mrhunsaker/Assistive_Switch_Interfaces/BLE_ADAPTIVE_SWITCH_EXPANDED_SCAFFOLD/BLE_Adaptive_Switch_District_Manual_Complete.docx

BLE ADAPTIVE SWITCH NODE

District Implementation Manual

Corrected & Expanded Edition

Written for teachers, paraeducators, AT specialists, and technology staff

Covers: device basics for the classroom · testing touch, proximity, and switch inputs

iPad/iPhone and Android pairing · firmware flashing · asset management · printable forms

Firmware: BLE_ADAPTIVE_SWITCH_EXPANDED_SCAFFOLD.ino + types_expanded.h

Device: ESP32-S3 SuperMini | BLE Profile: HID Keyboard (NimBLE stack)

Inputs: 6 capacitive touch · 1 proximity sensor · 4 mechanical switch jacks

Published by District Assistive Technology Department

# Table of Contents

# SECTION A — What This Device Does

The BLE Adaptive Switch Node is a small, wireless accessibility device built on the ESP32-S3 SuperMini microcontroller. It lets a student activate physical switches — things they touch, things they move near without touching, and things they press — and turns each activation into a standard Bluetooth keyboard keystroke.

Because it presents itself to the iPad, iPhone, or Android device as an ordinary Bluetooth keyboard, no app needs to be installed. iPadOS/iOS Switch Control and Android Switch Access both recognize it immediately and can map each input to scanning, selection, or navigation actions, exactly as they would for any commercial switch interface.

## A.1 The Three Kinds of Input

Input Type | How Many | How a Student Uses It | HID Keys Sent
Capacitive touch sensor | 6 | Lightly touch the sensor pad — no pressure needed | F1–F6
Proximity sensor | 1 | Move a hand or body part close to the sensor without touching it | F8
Mechanical switch (mono jack) | 4 | Press a standard adaptive switch plugged into a 3.5 mm jack | F9–F12

That is 11 independent inputs in total, and every single one sends a different key. This matters because Switch Control and Switch Access tell switches apart by which key arrives — if two inputs ever sent the same key, the software could not distinguish them.

## A.2 The LED — What Each Color Means

A single RGB indicator light (GPIO 48) gives instant feedback on every activation. The light tells you what TYPE of input just fired, not which specific sensor — this is a deliberate design choice that keeps the color code simple enough to memorize in a few seconds:

LED Color | Meaning
Green | A touch sensor was activated (F1–F6)
Red | The proximity sensor was activated (F8)
Blue | A switch / mono-jack input was activated (F9–F12)
Off / dark | Idle — no recent activation, or not yet connected

Remember it as: GREEN — you touched it. RED — it sensed you nearby. BLUE — you pressed it.

## A.3 What's Inside (Plain-Language Version)

- A small circuit board (ESP32-S3 SuperMini) that runs the program and talks over Bluetooth.
- Up to 6 small touch pads (TTP223 sensors) wired to the board.
- One proximity sensor that detects nearby motion without contact.
- Up to 4 standard 3.5 mm mono-jack sockets for plugging in adaptive switches.
- One small multicolor indicator light.
- A USB-C port for power and (for technology staff) for programming the device.
- An optional rechargeable battery for cable-free use during the school day.

No screen, no buttons to configure, and no companion app. Everything a teacher needs to do day-to-day is in Section B.

# SECTION B — For Teachers & Paraeducators: Daily Use and Testing

This section assumes no technical background. You will not need a computer, the Arduino IDE, or any programming knowledge to do anything described here. Everything in this section can be done with the device itself, the student's iPad/iPhone or Android device, and your own hands.

## B.1 Before You Start

Your technology department has already programmed (“flashed”) the device. You do not do that step — it is covered separately in Section D for IT staff. Your job is to power it on, pair it, test it, and use it.

## B.2 Powering the Device On

1. Plug in the USB-C cable, or switch on the battery if your unit has one.
2. Wait about 10 seconds. The indicator light may blink briefly during startup — this is normal.
3. Once startup finishes, the light goes dark and stays dark until an input is activated or it connects. A dark, idle light is the normal “ready and waiting” state, not a sign of failure.

## B.3 Pairing with an iPad or iPhone

1. On the iPad/iPhone, open Settings → Bluetooth.
2. Turn Bluetooth ON if it isn't already.
3. Under “Other Devices,” look for “BT Switch” (this is the device's default name; your district may have renamed it — see Section N).
4. Tap “BT Switch” to pair.
5. The device moves to “My Devices” and shows “Connected.”

After the first pairing, the iPad and the device reconnect automatically every time both are powered on — you should not need to repeat these steps daily.

## B.4 Pairing with an Android Tablet or Phone

1. On the Android device, open Settings → Connected devices (wording varies slightly by manufacturer/Android version) → Pair new device.
2. Look for “BT Switch” in the list of available devices.
3. Tap to pair. If a pairing code or confirmation prompt appears, accept it.
4. Confirm the device now shows as “Connected” under your paired/connected devices list.

This firmware has been verified on a Nokia G100 running Android 12 with Switch Access, and is expected to work the same way on other Android 9+ devices that support Bluetooth keyboards. If a specific Android device refuses to finish pairing, see Section G.3 — some Android devices need the battery status feature this device provides, and it is already built in.

## B.5 Turning On Switch Control (iPad / iPhone)

1. Open Settings → Accessibility → Switch Control.
2. Turn the Switch Control toggle ON. A scanning cursor will appear on screen.
3. Tap Switches → Add New Switch → External.
4. When prompted, activate the input you want to map (touch a pad, wave near the proximity sensor, or press a switch).
5. Give it a name you'll recognize (e.g., “Left Touch,” “Big Red Switch”) and choose the action it should perform.
6. Repeat for each input the student will use.

## B.6 Turning On Switch Access (Android)

1. If not already installed, install “Switch Access” from the Google Play Store.
2. Open Settings → Accessibility → Switch Access, and turn it ON.
3. Follow the in-app setup to add a switch: activate the desired input when prompted.
4. Assign the action you want that input to perform (e.g., move to next item, select).
5. Repeat for each input the student will use.

## B.7 Testing Each Kind of Input — The Most Important Section for Daily Use

Before any session with a student, and any time something seems “off,” test all three input types. You do not need any tools for this — just the device, and ideally a paired iPad or Android device so you can confirm the on-screen response as well as the LED.

### B.7.1 Testing a Touch Sensor

1. Lightly touch one of the touch pads (labeled Touch 1–6) with a fingertip or knuckle. No pressure is needed — these are capacitive sensors, like a phone screen.
2. Watch the indicator light: it should flash GREEN once.
3. If paired, watch the iPad/Android screen: the Switch Control or Switch Access cursor should respond exactly once per touch.
4. Lift off and touch again to confirm it fires once per touch, not continuously while held.

A touch sensor that never lights up green, or that fires repeatedly on its own without being touched, should be reported — see Section B.11.

### B.7.2 Testing the Proximity Sensor

1. Locate the proximity sensor — it is the small sensor window, separate from the touch pads and switch jacks.
2. Slowly bring a hand or other body part to within a few centimeters (roughly 1–4 inches) of the sensor window. Do not touch it — this sensor is designed to respond to nearness, not contact.
3. Watch the indicator light: it should flash RED once your hand is close enough.
4. Move your hand away. The sensor needs to see you move away before it will register the next activation — this is normal and prevents one long activation from repeating.

If the proximity sensor never lights up red no matter how close you get, it most likely needs technology staff to check its wiring or library configuration — see Section B.11 and Section G.

### B.7.3 Testing a Switch / Button Input

1. Plug a standard adaptive switch (3.5 mm mono plug) into one of the switch jacks (labeled Switch 1–4), if one is not already connected.
2. Press the switch.
3. Watch the indicator light: it should flash BLUE once per press.
4. Release and press again to confirm a single, clean activation each time.

### B.7.4 Quick Test Reference Card

Input Type | How to Test | LED Should Flash | On-Screen Result
Touch (Touch 1–6) | Lightly touch the pad | Green | Cursor moves / item selected, once per touch
Proximity | Hold hand ~1–4 in. away, then move it back | Red | Cursor moves / item selected, once per approach
Switch (Switch 1–4) | Press the connected switch | Blue | Cursor moves / item selected, once per press

## B.8 Daily Startup Checklist

☐ Power on the device and wait for startup to finish (light goes dark and idle).

☐ Confirm the iPad/Android device shows the device as “Connected.”

☐ Test at least one touch input — LED flashes green and the screen responds.

☐ Test the proximity sensor if the student uses it — LED flashes red and the screen responds.

☐ Test at least one switch input if the student uses it — LED flashes blue and the screen responds.

## B.9 Daily Shutdown Checklist

☐ Disconnect the device from the student's work area.

☐ Visually check all cables for damage, kinking, or fraying.

☐ Gently wiggle each connected adaptive switch cable to confirm it is seated firmly.

☐ Power off, or leave charging, per your building's protocol.

☐ Store the device in its designated location.

## B.10 Basic Troubleshooting (No Tech Required)

### A switch or sensor stopped responding mid-session

1. Check the Bluetooth/connection status on the iPad or Android device — it should show “Connected.”
2. If it shows disconnected, tap the device name to reconnect.
3. Check the physical cable between an adaptive switch and its jack — reseat it.
4. Try a different switch jack on the device, if available, to rule out a damaged jack.
5. If still unresponsive, contact your AT specialist or technology staff (Section B.11).

### The device disappeared from the Bluetooth/paired list

1. Power the device off completely, then back on. Wait about 15 seconds.
2. On the tablet, open Bluetooth/Connected devices settings — the device should reappear.
3. Tap to reconnect.
4. If it does not reappear within 30 seconds, try “forgetting” the device and re-pairing from scratch (Section B.3 / B.4).

### The LED never lights up at all, on any input

1. Confirm the device is actually powered — try a different USB-C cable, since many cables are charge-only.
2. If the device otherwise seems to work (it pairs, the screen responds) but the light itself never shows any color, this is most likely a hardware fault with the LED — report it (Section B.11). The device may still be safe to use for now since the LED is feedback only, not required for function.

## B.11 What to Report to Technology or AT Staff

Try the steps in B.10 first. Contact technology or AT staff if:

- The device will not power on after trying a different cable.
- Bluetooth will not reconnect after repeated restarts and re-pairing attempts.
- One or more inputs never register in any test, on any platform.
- There is visible physical damage to the enclosure, sensors, cables, or jacks.
- The proximity sensor never responds, even at very close range.
- The indicator light never illuminates at all, in any color.

# SECTION C — Hardware and GPIO Reference

This section is for AT specialists and technology staff who build, wire, or repair units. It reflects the actual firmware (BLE_ADAPTIVE_SWITCH_EXPANDED_SCAFFOLD.ino / types_expanded.h), not an earlier hardware revision.

## C.1 Hardware Components

Component | Purpose | Notes
ESP32-S3 SuperMini (ESP32S3FH4R2) | Main microcontroller | USB-C, BLE 5.0, in-package flash + PSRAM
TTP223 touch sensor modules (×6) | Capacitive touch input | 3.3V, digital output, active HIGH
I²C proximity sensor (×1) | Proximity input | APDS-9930, APDS-9960, VCNL4040, or VL53L0X — one per build
3.5 mm mono jack sockets (×4) | Adaptive switch input | Tip = signal, Sleeve = GND, INPUT_PULLUP
WS2812 NeoPixel LED | Visual feedback | GPIO 48, controlled by Adafruit NeoPixel
USB-C cable | Power and programming | Must be data-capable for flashing
3.7V 1100mAh LiPo battery (optional) | Cable-free power | Used with a TP4056 charge board

## C.2 GPIO Pin Reference

Signal | GPIO | Mode | HID Key | LED Color
Touch 1 | 1 | INPUT | F1 | Green
Touch 2 | 2 | INPUT | F2 | Green
Touch 3 | 4 | INPUT | F3 | Green
Touch 4 | 5 | INPUT | F4 | Green
Touch 5 | 6 | INPUT | F5 | Green
Touch 6 | 7 | INPUT | F6 | Green
Proximity (I²C) | SDA 8 / SCL 9 | I2C | F8 | Red
Switch 1 | 10 | INPUT_PULLUP | F9 | Blue
Switch 2 | 11 | INPUT_PULLUP | F10 | Blue
Switch 3 | 12 | INPUT_PULLUP | F11 | Blue
Switch 4 | 13 | INPUT_PULLUP | F12 | Blue
NeoPixel LED | 48 | OUTPUT | — | —

GPIO 3 is intentionally NOT used anywhere in this design, even though it would be electrically capable as a 7th touch input. It is a reset-time JTAG strapping pin, and this firmware avoids it entirely rather than relying on a sensor resting in the correct state at boot. As a direct result, F7 is permanently unused — this is by design, not an oversight.

## C.3 Reserved / Avoided Pins

GPIO | Reason
0 | BOOT button / boot-mode strapping
3 | JTAG-source strapping at reset (see callout above)
19 | USB D−
20 | USB D+
45 | VDD_SPI strapping (flash voltage)
46 | Boot-mode strapping (input-only)
48 | NeoPixel RGB LED (in use)

## C.4 Firmware Behavior Summary

- 35 ms software debounce on all 11 inputs, shared through one debounce routine.
- Edge-triggered: a keystroke fires once on activation, not repeatedly while held.
- Automatic BLE reconnection — the device re-advertises immediately if the host disconnects.
- LED fades smoothly toward its target color and fades back to off 250 ms after the last event, rather than snapping on/off.
- A standard Battery Service (UUID 0x180F, fixed at 100%) is included specifically because some Android hosts will not complete BLE HID pairing without one.

# SECTION D — Arduino IDE Setup and Firmware Flashing

This section is for technology staff only. Teachers and paraeducators do not need to perform any of these steps for normal classroom use.

## D.1 Prerequisites

Required hardware: ESP32-S3 SuperMini, a data-capable USB-C cable, a Windows/macOS/Linux computer.

Required files: BLE_ADAPTIVE_SWITCH_EXPANDED_SCAFFOLD.ino and types_expanded.h, in the same folder.

Internet connection: required for the initial board-support and library installation.

Estimated setup time: 30–60 minutes, mostly download/install waits.

## D.2 Install Arduino IDE

Download from https://www.arduino.cc/en/software for your operating system, run the installer with default options, and allow installation of USB/serial drivers when prompted.

## D.3 Install ESP32 Board Support

1. In Arduino IDE, open File → Preferences, and in “Additional Boards Manager URLs” paste: https://raw.githubusercontent.com/espressif/arduino-esp32/gh-pages/package_esp32_index.json
2. Open Tools → Board → Boards Manager, search “esp32,” and install “ESP32 by Espressif Systems.”

## D.4 Install Required Libraries

Open Sketch → Include Library → Manage Libraries and install each of the following:

Library | Required For | Notes
NimBLE-Arduino | BLE HID keyboard stack | by h2zero
Adafruit NeoPixel | Status LED | by Adafruit
SparkFun APDS9960 | Proximity sensor (default build) | Covers both APDS-9930 and APDS-9960
Adafruit VCNL4040 | Proximity sensor (alternate) | Only if using VCNL4040 instead
Adafruit VL53L0X | Proximity sensor (alternate) | Only if using VL53L0X instead

Wire is bundled with the ESP32 Arduino core and does not need separate installation.

## D.5 Choose the Proximity Sensor

Near the top of the .ino file, exactly one of the following four lines must be uncommented to match the physical sensor installed in the unit:

#define USE_APDS9930 (default) // #define USE_VCNL4040 // #define USE_VL53L0X // #define USE_APDS9960

If you change the sensor, also check PROX_I2C_ADDR and PROX_THRESHOLD a few lines below — each sensor family uses a different I²C address and a different practical threshold.

## D.6 Prepare and Open the Project

1. Place BLE_ADAPTIVE_SWITCH_EXPANDED_SCAFFOLD.ino and types_expanded.h together in one folder.
2. In Arduino IDE, choose File → Open and select the .ino file. types_expanded.h will open automatically in an adjacent tab — this is expected.

## D.7 Connect, Select Board and Port

1. Connect the board with a known data-capable USB-C cable.
2. Tools → Board → ESP32 Arduino → ESP32S3 Dev Module.
3. Tools → Port → select the port that appeared when the board was connected.

Selecting any board type other than ESP32S3 Dev Module is the most common cause of first-time compile or upload failure.

## D.8 Compile and Upload

1. Click Verify (✓) first. Expected result: “Done compiling.”
2. Click Upload (→). Expected final message: “Hard resetting via RTS pin…”
3. If upload fails on a fresh board, hold BOOT, briefly press and release RESET, release BOOT, then retry Upload within about 3 seconds.

### D.8.1 Common Compilation Errors

Error Message | Cause | Resolution
NimBLEDevice.h: No such file or directory | NimBLE-Arduino not installed | Install NimBLE-Arduino via Library Manager
Adafruit_NeoPixel.h: No such file or directory | NeoPixel library not installed | Install Adafruit NeoPixel via Library Manager
types_expanded.h: No such file or directory | Header not in the same folder | Move both files into one folder together
HIDKeyboardTypes.h: No such file or directory | Header is included but unused | Delete that #include line; no named constants from it are used
SparkFun_APDS9960.h: No such file or directory | Proximity library not installed, or wrong #define selected | Install the library matching the #define in Section D.5

## D.9 Serial Monitor Verification

Open Tools → Serial Monitor, set the baud rate to 115200, and reset the board. You should see setup logging end with “=== SETUP COMPLETE ===” and “=== BLE READY, ADVERTISING ===.” Every touch, proximity, and switch activation also logs its GPIO and assigned key here — this is the most reliable way to confirm a specific sensor by number, since the LED only reports input type.

# SECTION E — iPad / iOS Pairing and Switch Control Configuration (Detailed)

This is the detailed reference version of Section B.3/B.5, intended for AT specialists configuring a unit for a specific student for the first time.

## E.1 Pair the Device

1. Power on the BLE Switch Node.
2. On the iPad, open Settings → Bluetooth and ensure Bluetooth is ON.
3. Under Other Devices, locate “BT Switch” and tap to pair.
4. Accept any pairing confirmation prompts.
5. Confirm the device appears under My Devices showing Connected.

After first pairing, the iPad and switch node reconnect automatically on future power-ups, as long as the iPad has not “forgotten” the device.

## E.2 Configure Switch Control

### E.2.1 Enable Switch Control

1. Open Settings → Accessibility → Switch Control.
2. Tap the Switch Control toggle to turn it ON. The scanning cursor appears on screen.

### E.2.2 Add Each Switch

1. Within Switch Control settings, tap Switches → Add New Switch → External.
2. When prompted “Activate the switch,” touch the desired sensor or press the connected adaptive switch.
3. Enter a descriptive name (e.g., “Left Touch,” “Proximity – Head Approach,” “Right Switch”).
4. Select the Switch Control action to assign (e.g., Select Item, Move to Next Item).
5. Tap Save, and repeat for each input you want configured.

## E.3 Verify Input Operation

With Bluetooth connected, Switch Control enabled, and the Serial Monitor open (if a computer is available), activate each input and confirm:

Input Activated | Expected Serial Output | LED Color | Expected iPad Action
Touch 1–6 (any) | TOUCH n GPIO## -> F# (0x3A–0x3F) | Green | Configured Switch Control action fires once
Proximity | PROX near -> F8 (0x41) | Red | Configured Switch Control action fires once
Switch 1–4 (any) | SWITCH n GPIO## -> F# (0x42–0x45) | Blue | Configured Switch Control action fires once

# SECTION F — Android Pairing and Switch Access Configuration (Detailed)

This is the detailed reference version of Section B.4/B.6.

## F.1 Pair the Device

1. Power on the BLE Switch Node.
2. On the Android device, open Settings → Connected devices → Pair new device (menu names vary by manufacturer and Android version).
3. Locate “BT Switch” in the list of nearby devices and tap to pair.
4. Accept any confirmation/pairing-code prompts.
5. Confirm the device shows as Connected in the Connected devices list.

If pairing stalls or silently fails on a specific Android device, confirm the firmware build includes the Battery Service (UUID 0x180F) described in Section C.4 — this was required to complete pairing on the Nokia G100 / Android 12 reference device used to verify this firmware.

## F.2 Install and Enable Switch Access

1. Install “Switch Access” from the Google Play Store if not already present.
2. Open Settings → Accessibility → Switch Access and turn it ON.
3. Follow the in-app prompts to add a new switch: activate the desired physical input when asked.
4. Assign the action (e.g., Move to next item, Select) for that input.
5. Repeat for each input the student will use.

## F.3 Verify Input Operation

Input Activated | LED Color | Expected Android Action
Touch 1–6 (any) | Green | Configured Switch Access action fires once
Proximity | Red | Configured Switch Access action fires once
Switch 1–4 (any) | Blue | Configured Switch Access action fires once

# SECTION G — Troubleshooting Flowcharts and Escalation

## G.1 Device Will Not Power On

Step | Check | If NO — Action | If YES — Action
1 | USB-C cable connects device to computer/charger | Use a known data-capable cable | Proceed to step 2
2 | Does any LED appear during startup? | Try a different USB port/charger | Proceed to step 3
3 | Still dark after two cables, two sources? | Replace ESP32-S3 SuperMini board | Proceed to step 4
4 | Serial Monitor shows startup messages? | Reflash firmware per Section D | Device is functional — check BLE

## G.2 Device Will Not Upload (Flashing Failure)

Step | Check | If FAIL — Action | If PASS — Action
1 | Board set to ESP32S3 Dev Module? | Change board selection | Proceed to step 2
2 | Correct serial port selected? | Replug USB, refresh port list | Proceed to step 3
3 | Upload attempt — any error? | Try manual BOOT + RESET entry (Section D.8) | Proceed to step 4
4 | Still failing after BOOT entry? | Reinstall the ESP32 board package | Upload complete

## G.3 Bluetooth Will Not Connect

Step | Check | Negative — Action | Positive — Action
1 | Serial Monitor shows ADVERTISING STARTED? | Reflash firmware | Proceed to step 2
2 | “BT Switch” visible in the host's Bluetooth scan? | Reboot device, rescan on host | Proceed to step 3
3 | Pairing attempt succeeds? | Forget device on host, reboot device, retry | Proceed to step 4
4 | Host shows Connected? | Enable Switch Control / Switch Access | Configure switches

Android-specific: if pairing repeatedly fails at the “connecting…” stage specifically on Android (but works fine on iPad), confirm the firmware build includes the Battery Service — some Android BLE HID stacks require it to finalize the connection.

## G.4 Inputs Not Registering

Symptom | First Check | Second Check | Escalate If
Touch sensor unresponsive | Serial Monitor for TOUCH messages | Re-seat TTP223 wiring | No Serial output — replace TTP223
Proximity sensor unresponsive | Serial Monitor for an I²C error code at startup | Verify SDA=8/SCL=9 wiring and correct #define (Section D.5) | Sensor still silent — replace sensor or check address
Switch unresponsive | Test switch continuity with a multimeter | Check 3.5 mm jack seating | No continuity — replace switch or cable
Input fires repeatedly on its own | Check for debris/moisture on a touch pad | Confirm 35 ms debounce is intact in firmware | Replace sensor if still erratic
Wrong on-screen action triggered | Verify Switch Control / Switch Access assignment | Re-assign the action in settings | Contact AT specialist

## G.5 Escalation Matrix

Issue Level | Who Handles | Response Time | Escalate To
Bluetooth reconnect failure | Teacher or paraeducator | Immediate — reboot device | Tech staff if unresolved in 5 min
A switch/sensor not registering | Teacher or paraeducator | Immediate — check cable/test | AT specialist if hardware suspected
Firmware reflash required | Technology staff | Same school day | District AT coordinator
Hardware damage / board failure | Technology staff | Same school day | Replacement unit dispatch
New device deployment | Technology staff | Per deployment schedule | District IT for inventory entry
Student evaluation / configuration change | AT specialist | Per IEP timeline | Special education director

# SECTION H — Formal Acceptance Testing Procedure

Every unit must pass acceptance testing before assignment to a student. This procedure verifies firmware correctness, all 11 inputs, and connectivity on whichever platform(s) the unit will be used with.

## H.1 Pre-Deployment Acceptance Form

Field | Entry
Device ID / Asset Number
Bluetooth Advertised Name
Firmware Source File | BLE_ADAPTIVE_SWITCH_EXPANDED_SCAFFOLD.ino
ESP32 Chip ID (from Serial Monitor)
Proximity Sensor Type Installed
Target Platform(s) | ☐ iPad/iOS ☐ Android
Date of Testing
Technician Name
Assigned Student / Room (if known)

## H.2 Hardware Checks

☐ Visual inspection — no physical damage, loose wiring, or cracked enclosure

☐ USB-C connector seated and functional

☐ All 6 TTP223 touch sensors present and attached

☐ Proximity sensor present, attached, and wired to SDA=8 / SCL=9

☐ All 4 mono switch jacks present and undamaged

☐ NeoPixel LED present and not physically damaged

## H.3 Firmware and Startup Checks

☐ Device powers on — startup sequence visible

☐ Serial Monitor at 115200 baud shows the full setup sequence ending in “=== SETUP COMPLETE ===”

☐ “=== BLE READY, ADVERTISING ===” message confirmed

☐ Proximity sensor initializes without an I²C error in Serial Monitor

## H.4 Bluetooth Checks

☐ “BT Switch” (or custom name) visible in target device's Bluetooth scan

☐ Pairing completes without errors

☐ Target device shows Connected status

☐ Power-cycle reconnection test: power off, power back on, host reconnects automatically within ~10 seconds

## H.5 Input Verification — All 11 Inputs

☐ Touch 1 (GPIO 1) → F1, Serial shows TOUCH 0, LED flashes Green

☐ Touch 2 (GPIO 2) → F2, Serial shows TOUCH 1, LED flashes Green

☐ Touch 3 (GPIO 4) → F3, Serial shows TOUCH 2, LED flashes Green

☐ Touch 4 (GPIO 5) → F4, Serial shows TOUCH 3, LED flashes Green

☐ Touch 5 (GPIO 6) → F5, Serial shows TOUCH 4, LED flashes Green

☐ Touch 6 (GPIO 7) → F6, Serial shows TOUCH 5, LED flashes Green

☐ Proximity → F8, Serial shows PROX near, LED flashes Red

☐ Switch 1 (GPIO 10) → F9, Serial shows SWITCH 0, LED flashes Blue

☐ Switch 2 (GPIO 11) → F10, Serial shows SWITCH 1, LED flashes Blue

☐ Switch 3 (GPIO 12) → F11, Serial shows SWITCH 2, LED flashes Blue

☐ Switch 4 (GPIO 13) → F12, Serial shows SWITCH 3, LED flashes Blue

## H.6 Switch Control / Switch Access Integration Test

☐ Switch Control (iPad) or Switch Access (Android) enabled on the target device

☐ All intended inputs assigned in the accessibility settings

☐ Scanning/selection responds correctly to touch inputs

☐ Scanning/selection responds correctly to the proximity sensor

☐ Scanning/selection responds correctly to switch inputs

## H.7 Final Result

Result | Technician Signature | Date
PASS / FAIL (circle one)

If FAIL: document the failure mode below and do not deploy the unit until resolved.

Failure notes (continue on back if needed) | Date reviewed

# SECTION I — Asset Management

## I.1 Inventory Record Template

Maintain one row per physical device in the district inventory system (spreadsheet, database, or asset management platform).

Field | Description / Format
Asset Number | District-assigned unique identifier (e.g., AT-2026-001)
Bluetooth Name | Advertised BLE name programmed in firmware (default: BT Switch)
Proximity Sensor Type | APDS-9930 / APDS-9960 / VCNL4040 / VL53L0X
Build Date | Date unit was assembled and flashed
Acceptance Test Date | Date of most recent acceptance test (Section H)
Acceptance Test Result | PASS or FAIL
Current Building / Room | Building name or code and room number
Assigned Staff | Teacher or AT specialist name
Assigned Student | Student ID only — never the student's name
Last Inspection Date | Date of most recent monthly inspection
Next Inspection Due | Calculated 30 days from last inspection
Decommission Date | Date unit was retired from service

## I.2 Device Checkout Form

Complete when any unit leaves the technology department or changes assignment.

Field | Entry
Asset Number
Bluetooth Name
Checked Out To (Staff Name)
Building / Room
Student ID (if assigned)
Date Checked Out
Expected Return Date (if temporary)
Condition at Checkout | Good / Minor wear / Needs repair

Technology Staff Signature / Date | Receiving Staff Signature / Date

# SECTION J — Paraeducator Quick Reference Card

PRINT THIS PAGE AND KEEP IT WITH THE DEVICE. Laminate for durability.

## Every Morning

☐ Power on the switch node

☐ Host device (iPad or Android) shows Connected

☐ Activate one touch input — LED flashes Green, screen responds

☐ Activate the proximity sensor (if used) — LED flashes Red, screen responds

☐ Activate one switch input (if used) — LED flashes Blue, screen responds

## LED Color Guide

LED Color | What It Means
Green | A touch sensor (Touch 1–6) was activated
Red | The proximity sensor was activated
Blue | A switch (Switch 1–4) was activated
Dark / Off | No input, or no connection yet

## If a Switch Stops Working

Try This First | Then Try | Then Call
Check Bluetooth — shows Connected? | Reboot device: power off, wait 10 sec, power on | AT specialist or technology staff
Wiggle the cable at the jack | Try a different jack on the device | Technology staff if hardware issue
Restart Switch Control/Access: OFF, wait 5 sec, ON | Forget and re-pair the device | AT specialist if software/config issue

## If the Device Disappears from the Paired List

1. Power off the switch node.
2. Wait 10 seconds.
3. Power it back on.
4. Open Bluetooth/Connected devices settings on the host.
5. The device name should reappear — tap to reconnect.

## Who to Call

Situation | Contact
Bluetooth will not reconnect after restart | Technology Department
A switch is not working — hardware suspected | Technology Department
Student's scanning pattern needs adjustment | AT Specialist
Switch Control / Switch Access actions need reconfiguring | AT Specialist or Teacher
Physical damage to the device | Technology Department

# SECTION K — Technology Department Maintenance Procedures

## K.1 Monthly Maintenance Checklist

Complete for every active unit each calendar month. File completed checklists in the device folder.

☐ Confirm firmware matches the district-approved version

☐ Power on — complete startup sequence visible in Serial Monitor

☐ Bluetooth advertisement visible from a host scan

☐ Pair or reconnect — host shows Connected

☐ Touch 1–6 each activate — correct Serial output and Green LED

☐ Proximity sensor activates — correct Serial output and Red LED

☐ Switch 1–4 each activate — correct Serial output and Blue LED

☐ Power-cycle reconnection test passes

☐ Physical inspection — no damage

Technician Signature | Date

## K.2 Quarterly Maintenance

- Physical inspection of all units: enclosure, connectors, cables.
- Full inventory audit: confirm physical count matches database records.
- Confirm all units run the current district-approved firmware version.
- Review incident reports filed since the last quarterly review.
- Update inventory records with current building/room/staff assignments.

## K.3 Annual Maintenance

- Reflash all units with the then-current district-approved firmware.
- Complete a full acceptance test (Section H) on every unit after reflashing.
- Update the firmware version log (Section O) with the annual version.
- Review and update training materials if firmware behavior changed.
- Conduct a full inventory audit and decommission damaged/obsolete units.

## K.4 Firmware Update Approval Form

Field | Entry
New Firmware Version / Filename
Previous Firmware Version / Filename
Date of Change
Summary of Changes
Testing Completed By
Number of Units Tested
Pass Rate
Approved By (Technology Director)
Approved By (AT Coordinator)
Deployment Date

Technology Director Signature / Date | AT Coordinator Signature / Date

# SECTION L — AT Specialist Evaluation Form

Completed by the Assistive Technology Specialist when evaluating a student's use of the BLE Adaptive Switch Node.

FERPA NOTICE: This form contains student-specific information. Store per district FERPA policies. Do not attach to or store with the device hardware.

## L.1 Student and Device Information

Field | Entry
Student ID (do not write name on device forms)
Evaluation Date
AT Specialist Name
IEP Meeting Date (if applicable)
Device Asset Number Used During Evaluation
Target Platform | ☐ iPad/iOS ☐ Android

## L.2 Access Method Evaluated

☐ Capacitive touch sensors (one or more of Touch 1–6)

☐ Proximity sensor

☐ Mechanical switches via mono jack (one or more of Switch 1–4)

☐ Combination of touch, proximity, and/or switch

☐ Access method currently under evaluation — not yet determined

### L.2.1 Physical Positioning

Describe switch or sensor placement observed during evaluation:

### L.2.2 Accuracy

Metric | Observation
Correct activations per 10 attempts
Unintended activations per 10 attempts
Average time from intent to activation
Consistent activation force / approach distance? | Yes / No / Variable

### L.2.3 Fatigue

Metric | Observation
Duration of sustained use before fatigue signs
Observed fatigue indicators
Recommended maximum session length

### L.2.4 Student Response to LED Feedback

☐ Student notices and responds to LED color changes

☐ LED feedback does not appear to influence student behavior

☐ LED feedback is distracting — consider covering or disabling

## L.3 Recommendations

Switch configuration recommendation for IEP:

Positioning recommendation:

Training recommendation for staff:

Follow-up evaluation recommended: Yes / No If yes, within: ________ weeks

AT Specialist Signature | Date

# SECTION M — FERPA and Student Privacy Guidance

## M.1 What FERPA Requires

The Family Educational Rights and Privacy Act (FERPA) prohibits unauthorized disclosure of personally identifiable information from student education records. Technology staff and educators must follow this section when deploying the BLE Adaptive Switch Node.

## M.2 What Must Not Be Stored on the Device

The ESP32-S3 SuperMini has no non-volatile storage accessible to the firmware beyond the program flash itself. No student information of any kind is stored on or transmitted by the firmware. District staff must still follow the naming restrictions below.

### M.2.1 Bluetooth Device Names Must Not Contain:

- Student full names or partial names
- Student ID numbers
- Any medical diagnosis or disability category
- Classroom identifiers that would allow identification of a specific student

Compliant Naming Examples | Non-Compliant Naming Examples
BT Switch B1-001 | BT Switch John Smith (contains a student name)
BT Switch Room 14A | Switch 042839 (contains a student ID)
BT Switch 07 | CP Switch Room 14 (contains a disability category)

## M.3 Inventory Systems

- Inventory databases linking Asset Numbers to student identifiers must comply with district FERPA data governance policies.
- Printed inventory sheets with student ID assignments must be stored securely, never left in classrooms.
- Device labels must use asset numbers only, never student names.

## M.4 Evaluation Records

- AT specialist evaluation forms (Section L) contain student-identifiable information and must be stored in the student's file per FERPA requirements.
- Do not photograph, scan, or transmit these forms through non-secure channels.
- Completed evaluation forms must not be left with the physical device or in unsecured classrooms.

## M.5 Questions

Contact your district FERPA compliance officer or special education director with any questions about whether a specific practice complies with FERPA.

# SECTION N — Multi-Building Deployment Standards

## N.1 Device Naming Convention

When deploying multiple units across buildings, program a unique Bluetooth name into each unit before flashing to prevent confusion when several devices are powered on in the same space.

Format: BT Switch [Building Code]-[Unit Number] — Examples: BT Switch B1-001, BT Switch B1-002, BT Switch ES-014, BT Switch MS-003

## N.2 How to Change the Bluetooth Name

Before compiling firmware for a specific unit, locate this line near the top of setupBLE() in the .ino file:

NimBLEDevice::init("BT Switch");

Change the string to the unit's assigned name, for example:

NimBLEDevice::init("BT Switch B1-001");

Compile and flash. The advertised name (set elsewhere via advData.setName(...) in the same function) should be updated to match. Each unit then advertises its unique name.

## N.3 Central Inventory Database

Maintain a single district-level inventory tracking all units regardless of building, including at minimum: asset number, Bluetooth name, current building/room/staff, student ID assignment (secured per FERPA), proximity sensor type, and last acceptance test date.

## N.4 Cross-Building Transfer Procedure

1. Update the inventory record with the new building, room, and staff assignment.
2. Confirm the Bluetooth name is appropriate for the new location (rename in firmware if needed).
3. Complete a transfer inspection using the monthly checklist (Section K.1).
4. Notify the receiving building's AT specialist of the transfer.
5. Confirm the receiving host device can successfully pair or reconnect.

# SECTION O — Change Management and Firmware Version Control

## O.1 Firmware Version Log

Record every firmware version ever deployed district-wide. Never delete previous entries.

Version | Release Date | Approved By | Change Summary | Rollback Procedure
2.0.0 (Expanded Scaffold, board-verified) | | | 11-input redesign: 6 touch + 1 proximity + 4 switch; 3-color LED scheme; Battery Service added for Android | Section O.3

## O.2 Change Approval Process

- Technology staff or AT coordinator identifies the need for a firmware change.
- The change is documented and tested on at least 2 units before broad deployment.
- Technology Director and AT Coordinator review and sign the Firmware Update Approval Form (Section K.4).
- Approved firmware is deployed to all units within the designated maintenance window.
- All units are acceptance tested post-flash (full or abbreviated, per supervisor direction).
- The version log (O.1) is updated.

## O.3 Rollback Procedure

1. Locate the previous approved firmware source files in district technology archive storage.
2. Flash all affected units with the previous version using the standard procedure (Section D).
3. Document the rollback in the firmware version log with date and reason.
4. Do not deploy the problem version to additional units until the issue is resolved.

Retain the full source for every version ever deployed (both the .ino and the matching types_expanded.h) in district network storage, not only on individual technicians' computers. Losing a previous version removes the ability to roll back.

# SECTION P — Printable Appendices

## Appendix A — Device Checkout Form

(See Section I.2 for the full form. Reproduce this page for daily use.)

Field | Entry
Asset Number
Bluetooth Name
Date Checked Out
Checked Out To
Building / Room
Student ID
Condition at Checkout | Good / Minor wear / Needs repair
Expected Return Date

Borrowing Staff Signature / Date | Technology Staff Signature / Date

## Appendix B — Classroom Daily Verification Form

Teacher or paraeducator completes daily. Keep with the device or in the classroom binder.

Date | Powered On | Connected | Platform | Inputs Tested | Issue Noted | Initials
| ☐ | ☐ | iPad / Android | ☐ Touch ☐ Prox ☐ Switch
| ☐ | ☐ | iPad / Android | ☐ Touch ☐ Prox ☐ Switch
| ☐ | ☐ | iPad / Android | ☐ Touch ☐ Prox ☐ Switch
| ☐ | ☐ | iPad / Android | ☐ Touch ☐ Prox ☐ Switch
| ☐ | ☐ | iPad / Android | ☐ Touch ☐ Prox ☐ Switch
| ☐ | ☐ | iPad / Android | ☐ Touch ☐ Prox ☐ Switch
| ☐ | ☐ | iPad / Android | ☐ Touch ☐ Prox ☐ Switch
| ☐ | ☐ | iPad / Android | ☐ Touch ☐ Prox ☐ Switch

## Appendix C — Incident Report Form

Field | Entry
Asset Number
Date of Incident
Reported By (name and role)
Building / Room
Student ID (if involved)
Description of Incident
Immediate Action Taken
Follow-up Required? | Yes / No
Assigned To
Resolution Date
Resolution Summary

Reporting Staff Signature / Date | Technology Staff Signature / Date

## Appendix D — Annual Inspection Form

☐ Enclosure — no cracks, loose parts, or sharp edges

☐ USB-C connector functional for charging and data

☐ All 6 TTP223 touch sensors present and responsive

☐ Proximity sensor present, wired, and responsive

☐ All 4 mono switch jacks present and functional

☐ NeoPixel LED illuminates Green / Red / Blue correctly

☐ Full startup sequence confirmed in Serial Monitor

☐ Bluetooth advertising and pairing functional on intended platform(s)

☐ All 11 inputs verified per the Acceptance Test (Section H)

☐ Firmware version matches the current district-approved version

☐ Inventory record updated

Annual Inspection Technician / Date | Technology Director Approval / Date

## Appendix E — Firmware Update Approval Form

(See Section K.4 for the full form. Reproduce this page as needed.)

Field | Entry
New Firmware Version / Filename
Previous Firmware Version / Filename
Summary of Changes
Test Units Count
Test Pass Rate
Approved By — Technology Director
Approved By — AT Coordinator
Deployment Date
Rollback Instructions (attach or reference)

Technology Director Signature / Date | AT Coordinator Signature / Date

## Appendix F — AT Evaluation Worksheet (Abbreviated Field Copy)

(Full form in Section L. This is a condensed field copy for use during evaluation sessions.)

Field | Entry
Student ID
Evaluation Date
AT Specialist
Device Asset Number
Platform | iPad / Android
Access Method Evaluated | Touch / Proximity / Switch / Combination
Correct activations / 10 trials
Unintended activations / 10 trials
Fatigue threshold observed
Recommended switch configuration
Follow-up needed? | Yes / No — Within: ___ weeks

AT Specialist Signature | Date

BLE Adaptive Switch Node — District Implementation Manual Corrected & Expanded Edition
