mrhunsaker/Assistive_Switch_Interfaces/BLE_ADAPTIVE_SWITCH_EXPANDED_SCAFFOLD/old/BLE_Adaptive_Switch_District_Manual_Complete.docx

BLE ADAPTIVE SWITCH NODE

District Deployment Manual

Expanded Edition

Comprehensive guide for teachers, paraeducators, AT specialists,

technology staff, and district administrators.

Covers: Arduino IDE setup · Firmware flashing · iPad pairing · District deployment

Asset management · Staff training · Compliance · Printable forms

Firmware: BLE_TTP223_SWITCH_FUNCTION_STATE_MODEL

Device: ESP32-S3 Supermini | BLE Profile: HID Keyboard

Published by District Assistive Technology Department

# Table of Contents

# SECTION A — SYSTEM DOCUMENTATION

## A.1 What This Device Does

The BLE Adaptive Switch Node is a small, wireless accessibility device built on the ESP32-S3 Supermini microcontroller. It bridges physical switch inputs — capacitive touch sensors and adaptive switches — to Apple iPads and iPhones through Bluetooth Low Energy (BLE) using the standard HID Keyboard profile.

Students who cannot use a standard touchscreen can activate physical switches to drive all of iPadOS Switch Control, including scanning, selection, and full app navigation.

### A.1.1 HID Keyboard Mapping

Input | Bluetooth Action Sent | Default Switch Control Function
Touch Sensor 1 / Switch Jack 1 | Shift + Tab | Move to previous item
Touch Sensor 2 / Switch Jack 2 | Tab | Move to next item / Scan
Touch Sensor 3 / Switch Jack 3 | Enter | Select highlighted item

### A.1.2 Bluetooth Identity

Default Bluetooth advertisement name: BT Switch Node

Profiles supported: BLE HID Keyboard

Bonding: Enabled (reconnects automatically on power-up)

Range: Approximately 10 meters line-of-sight

## A.2 Hardware Components

Component | Purpose | Notes
ESP32-S3 Supermini | Main microcontroller | USB-C, BLE 5.0
TTP223 touch sensor modules (x3) | Capacitive touch input | 3.3V, digital output
3.5 mm mono jack sockets (x3) | Adaptive switch input | Tip = signal, Sleeve = GND
WS2812B NeoPixel LED | Visual feedback | GPIO 48, controlled by Adafruit NeoPixel
USB-C cable | Power and programming | Data-capable cable required for flashing

### A.2.1 GPIO Pin Reference

Signal | GPIO | Mode | Connected To
Touch 1 | GPIO 4 | INPUT | TTP223 OUT pin
Touch 2 | GPIO 5 | INPUT | TTP223 OUT pin
Touch 3 | GPIO 6 | INPUT | TTP223 OUT pin
Switch Jack 1 | GPIO 10 | INPUT_PULLUP | 3.5 mm jack tip
Switch Jack 2 | GPIO 11 | INPUT_PULLUP | 3.5 mm jack tip
Switch Jack 3 | GPIO 12 | INPUT_PULLUP | 3.5 mm jack tip
NeoPixel LED | GPIO 48 | OUTPUT | WS2812B DIN

### A.2.2 LED Status Colors

Activation | LED Color | Meaning
Touch Sensor 1 | Purple | Shift+Tab sent
Touch Sensor 2 | Red | Tab sent
Touch Sensor 3 | Green | Enter sent
Switch Jack 1 | Blue | Shift+Tab sent
Switch Jack 2 | Cyan | Tab sent
Switch Jack 3 | Yellow | Enter sent
No connection | Off / slow pulse | Advertising, no host paired

## A.3 Firmware Behavior

- 35 ms software debounce on all inputs prevents false triggers
- Automatic BLE reconnection — device re-advertises if host disconnects
- Bluetooth bonding — iPad remembers the device after first pairing
- Non-blocking LED fades — switch inputs remain responsive during LED animation
- Touch sensors: active HIGH (TTP223 output goes HIGH on touch)
- Switch jacks: active LOW (INPUT_PULLUP; switch closure pulls GPIO to ground)
- Firmware converts both input types to a consistent Pressed = TRUE model internally

# SECTION B — ARDUINO IDE SETUP AND FIRMWARE FLASHING

## B.1 Prerequisites

Required hardware: ESP32-S3 Supermini, USB-C data cable, Windows/macOS/Linux computer

Required files: BLE_TTP223_SWITCH_FUNCTION_STATE_MODEL.ino and types.h

Internet connection required for initial installation of board support and libraries.

Estimated total setup time: 30–60 minutes (most time is download/install waits).

## B.2 Install Arduino IDE

### B.2.1 Download

Navigate to: https://www.arduino.cc/en/software

Operating System | Download Target
Windows 10/11 (64-bit) | Windows Win 10 and newer, 64-bit
macOS Intel | macOS Intel
macOS Apple Silicon (M1/M2/M3) | macOS Apple Silicon
Linux | Appropriate Linux AppImage or package

### B.2.2 Install

1. Run the downloaded installer.
2. Accept all default options.
3. When prompted, allow installation of USB drivers, serial drivers, and device drivers.
4. Launch Arduino IDE when installation completes.

SCREENSHOT AI-01: Arduino IDE first launch. Capture the full IDE window showing the default empty sketch.

F2F2F2

## B.3 Install ESP32 Board Support

### B.3.1 Add Board Manager URL

5. In Arduino IDE, open: File → Preferences
6. Locate the field labeled: Additional Boards Manager URLs
7. Paste the following URL exactly:

https://raw.githubusercontent.com/espressif/arduino-esp32/gh-pages/package_esp32_index.json

8. Click OK.

### B.3.2 Install ESP32 Package

9. Open: Tools → Board → Boards Manager
10. In the search box, type: esp32
11. Locate: ESP32 by Espressif Systems
12. From the version dropdown, select: 2.0.17 (this is the version validated with this firmware)
13. Click Install.
14. Wait for installation to complete. This may take 5–15 minutes on a slower connection.

SCREENSHOT AI-02: File → Open menu sequence.

F2F2F2

SCREENSHOT AI-03: Boards Manager with 'esp32' in the search field.

F2F2F2

SCREENSHOT AI-04: ESP32 package installation page with version 2.0.17 selected and Install button.

F2F2F2

## B.4 Install Required Libraries

### B.4.1 Open Library Manager

Select: Sketch → Include Library → Manage Libraries

### B.4.2 NimBLE-Arduino

15. In the Library Manager search box, type: NimBLE-Arduino
16. Locate: NimBLE-Arduino by h2zero
17. Select version: 2.5.0
18. Click Install.

SCREENSHOT AI-05: Library Manager showing NimBLE-Arduino search result with version 2.5.0 selected.

F2F2F2

### B.4.3 Adafruit NeoPixel

19. In the Library Manager search box, type: Adafruit NeoPixel
20. Locate: Adafruit NeoPixel by Adafruit
21. Select version: 1.15.5
22. Click Install.
23. If prompted to install dependencies, click Install All.

SCREENSHOT AI-06: Library Manager showing Adafruit NeoPixel search result with version 1.15.5 selected.

F2F2F2

## B.5 Prepare the Firmware Project

### B.5.1 Required File Structure

Create a folder named exactly: BLE_TTP223_SWITCH_FUNCTION_STATE_MODEL

Place both firmware files inside this folder:

BLE_TTP223_SWITCH_FUNCTION_STATE_MODEL/

BLE_TTP223_SWITCH_FUNCTION_STATE_MODEL.ino

types.h

IMPORTANT: The folder name must exactly match the .ino filename.

IMPORTANT: Both files must be in the same folder. Do not rename either file.

### B.5.2 Open the Project

24. Launch Arduino IDE.
25. Select: File → Open
26. Navigate to the firmware folder and open: BLE_TTP223_SWITCH_FUNCTION_STATE_MODEL.ino
27. Arduino IDE will automatically open both the .ino file and types.h as separate tabs. This is normal and expected.

SCREENSHOT AI-02 (reference): File → Open menu. Show the menu open with Open highlighted.

F2F2F2

## B.6 Connect the ESP32

Connect the ESP32-S3 Supermini to the computer using a USB-C cable.

IMPORTANT: Many USB-C cables are charge-only and do not carry data.

If the device is not detected after connecting, try a different cable before troubleshooting further.

Data-capable cables are often labeled as such, or are included with devices like phones, tablets, or headphones.

## B.7 Select the Board

28. In Arduino IDE, open: Tools → Board → ESP32 Arduino
29. Select: ESP32S3 Dev Module

CRITICAL: You must select ESP32S3 Dev Module specifically.

Selecting any other board type will cause compilation or upload failures.

This selection is the most common source of first-time setup errors.

SCREENSHOT AI-07: Tools → Board menu showing ESP32S3 Dev Module highlighted and selected.

F2F2F2

## B.8 Select the COM Port

30. Open: Tools → Port
31. Select the port that appeared when you connected the ESP32.

Operating System | Expected Port Format | Example
Windows | COM followed by a number | COM5, COM8, COM12
macOS | Starts with /dev/cu.usbmodem | /dev/cu.usbmodem14201
Linux | Starts with /dev/ttyACM or /dev/ttyUSB | /dev/ttyACM0

If no port appears: replace the USB cable, reconnect the board, and restart Arduino IDE.

SCREENSHOT AI-08: Tools → Port menu showing a COM port selected.

F2F2F2

## B.9 Compile the Firmware

Before uploading, always compile first to check for errors.

32. Click the checkmark (✓) Verify button in the toolbar, or select: Sketch → Verify/Compile
33. Arduino IDE will check syntax, compile libraries, and build the firmware binary.
34. Expected result in the output panel: Done compiling.

SCREENSHOT AI-09: Verify button highlighted in the toolbar during compilation.

F2F2F2

SCREENSHOT AI-10: Output panel showing 'Done compiling.' with no errors.

F2F2F2

### B.9.1 Common Compilation Errors

Error Message | Cause | Resolution
NimBLEDevice.h: No such file or directory | NimBLE-Arduino library not installed | Install NimBLE-Arduino v2.5.0 via Library Manager
Adafruit_NeoPixel.h: No such file or directory | NeoPixel library not installed | Install Adafruit NeoPixel v1.15.5 via Library Manager
types.h: No such file or directory | types.h not in same folder as .ino | Move both files into the same named folder
Board not found / no ESP32 boards | ESP32 board package not installed | Install ESP32 by Espressif Systems v2.0.17

## B.10 Upload Firmware

35. Click the right-arrow (→) Upload button in the toolbar, or select: Sketch → Upload
36. Arduino IDE will compile, connect to the ESP32, erase flash, write firmware, and verify.
37. Typical upload time: 30–90 seconds.
38. Expected final message: Hard resetting via RTS pin...
39. Upload is complete when this message appears.

SCREENSHOT AI-11: Upload button highlighted in the toolbar.

F2F2F2

SCREENSHOT AI-12: Output panel showing 'Hard resetting via RTS pin...' indicating successful upload.

F2F2F2

### B.10.1 If Upload Fails — Manual Bootloader Entry

Some ESP32-S3 boards require manual entry into the bootloader before the first flash:

40. Hold the BOOT button on the ESP32 board.
41. While holding BOOT, briefly press and release the RESET button.
42. Release the BOOT button.
43. Immediately retry the Upload in Arduino IDE within 3 seconds.

This sequence puts the ESP32 into programming mode manually. It is only needed if automatic upload fails.

## B.11 Serial Monitor Verification

44. Open: Tools → Serial Monitor
45. Set the baud rate to: 115200
46. Press the RESET button on the ESP32.

Expected startup output:

=== SETUP START ===

=== PINS OK ===

=== NEOPIXEL OK ===

=== BLE INIT START ===

=== BLE DEVICE INIT OK ===

=== HID DEVICE CREATED ===

=== HID SERVICES STARTED ===

=== ADVERTISING STARTED ===

=== SETUP COMPLETE ===

All eight lines must appear. Any missing line indicates a firmware initialization failure.

SCREENSHOT AI-13: Serial Monitor at 115200 baud showing the full startup message sequence.

F2F2F2

# SECTION C — iPAD PAIRING AND SWITCH CONTROL CONFIGURATION

## C.1 Pair the Device

47. Power on the BLE Switch Node.
48. On the iPad, open: Settings → Bluetooth
49. Ensure Bluetooth is turned ON.
50. Under Other Devices, locate: BT Switch Node
51. Tap BT Switch Node to initiate pairing.
52. Accept any pairing confirmation prompts.
53. The device will move to the My Devices section showing Connected.

SCREENSHOT IP-01: Settings → Bluetooth showing the Bluetooth screen.

F2F2F2

SCREENSHOT IP-02: Bluetooth screen showing BT Switch Node visible under Other Devices.

F2F2F2

SCREENSHOT IP-03: Bluetooth screen showing BT Switch Node listed under My Devices with Connected status.

F2F2F2

After first pairing, the iPad and switch node will reconnect automatically on all future power-ups.

## C.2 Configure Switch Control

### C.2.1 Enable Switch Control

54. Open: Settings → Accessibility → Switch Control
55. Tap the Switch Control toggle to turn it ON.
56. The scanning cursor will appear on screen.

SCREENSHOT IP-04: Accessibility settings menu.

F2F2F2

SCREENSHOT IP-05: Switch Control settings screen with the master toggle.

F2F2F2

### C.2.2 Add Each Switch

57. Within Switch Control settings, tap: Switches → Add New Switch → External
58. When the prompt Activate the switch appears, touch the desired sensor or press the connected adaptive switch.
59. Enter a descriptive name for the switch (e.g., Left Touch, Right Switch).
60. Select the Switch Control action to assign (e.g., Select Item, Move to Next Item).
61. Tap Save.
62. Repeat for each input you wish to configure.

SCREENSHOT IP-06: Add New Switch screen.

F2F2F2

SCREENSHOT IP-07: External switch detection prompt.

F2F2F2

SCREENSHOT IP-08: Action assignment screen showing available Switch Control actions.

F2F2F2

SCREENSHOT IP-09: Completed switch list showing all configured inputs.

F2F2F2

## C.3 Verify Input Operation

With Bluetooth connected and Switch Control enabled, activate each input and observe the Serial Monitor:

Input Activated | Expected Serial Output | Expected iPad Action
Touch Sensor 1 | TOUCH 0 -> SHIFT+TAB | Move to previous item
Touch Sensor 2 | TOUCH 1 -> TAB | Move to next item
Touch Sensor 3 | TOUCH 2 -> ENTER | Select highlighted item
Switch Jack 1 | SWITCH 0 -> SHIFT+TAB | Move to previous item
Switch Jack 2 | SWITCH 1 -> TAB | Move to next item
Switch Jack 3 | SWITCH 2 -> ENTER | Select highlighted item

# SECTION D — TROUBLESHOOTING FLOWCHARTS AND ESCALATION

## D.1 Device Will Not Power On

Step | Check | If NO — Action | If YES — Action
1 | Connect USB-C cable to device and computer | Use a known-good data cable | Proceed to step 2
2 | Does any LED light appear? | Try a different USB port on the computer | Proceed to step 3
3 | LED still absent after two cables, two ports? | Replace ESP32-S3 Supermini board | Proceed to step 4
4 | Serial Monitor shows startup messages? | Reflash firmware per Section B | Device is functional — check BLE

## D.2 Device Will Not Upload (Flashing Failure)

Step | Check | If FAIL — Action | If PASS — Action
1 | Board set to ESP32S3 Dev Module? | Change board selection | Proceed to step 2
2 | Correct COM port selected? | Replug USB, refresh port list | Proceed to step 3
3 | Upload attempt — any error? | Try manual BOOT+RESET entry | Proceed to step 4
4 | Still failing after BOOT entry? | Reinstall ESP32 package v2.0.17 | Upload complete

## D.3 Bluetooth Will Not Connect

Step | Check | Negative Result — Action | Positive Result — Action
1 | Serial Monitor shows ADVERTISING STARTED? | Reflash firmware | Proceed to step 2
2 | BT Switch Node visible in iPad Bluetooth scan? | Reboot ESP32, rescan iPad | Proceed to step 3
3 | Pairing attempt succeeds? | Forget device on iPad, reboot ESP32, retry pair | Proceed to step 4
4 | iPad shows Connected? | Check Switch Control is enabled | Configure Switch Control

## D.4 Switch Inputs Not Registering

Symptom | First Check | Second Check | Escalate If
Touch sensor unresponsive | Serial Monitor for TOUCH messages | Re-seat TTP223 sensor wiring | No Serial output — replace TTP223
Adaptive switch unresponsive | Test switch with multimeter for continuity | Check 3.5 mm jack seating | No continuity — replace switch or cable
Input fires repeatedly | Check for debris on sensor surface | Check 35 ms debounce in firmware | Replace TTP223 if still erratic
Wrong action triggered | Verify Switch Control assignment | Re-assign action in Switch Control settings | Contact AT specialist

## D.5 Escalation Matrix

Issue Level | Who Handles | Response Time | Escalate To
Bluetooth reconnect failure | Teacher or paraeducator | Immediate — reboot device | Tech staff if unresolved in 5 min
Switch not registering | Teacher or paraeducator | Immediate — check cable | AT specialist if hardware related
Firmware reflash required | Technology staff | Same school day | District AT coordinator
Hardware damage / board failure | Technology staff | Same school day | Replacement unit dispatch
New device deployment | Technology staff | Per deployment schedule | District IT for inventory entry
Student evaluation change | AT specialist | Per IEP timeline | Special education director

# SECTION E — FORMAL ACCEPTANCE TESTING PROCEDURES

## E.1 Purpose

Every BLE Adaptive Switch Node unit must pass formal acceptance testing before being assigned to a student. This procedure verifies that the firmware is correct, all inputs function, and Bluetooth connectivity meets operational requirements.

## E.2 Pre-Deployment Acceptance Form

BLE ADAPTIVE SWITCH NODE — PRE-DEPLOYMENT ACCEPTANCE FORM

Complete one form per unit. Retain original in the technology department.

Attach a copy to the device checkout record.

Field | Entry
Device ID / Asset Number
Bluetooth Advertised Name
Firmware Version
ESP32 Chip ID (from Serial Monitor)
Date of Testing
Technician Name
Assigned Student / Room (if known)

### E.2.1 Hardware Checks

☐ Visual inspection — no physical damage, loose wiring, or cracked enclosure

☐ USB-C connector seated and functional

☐ All three TTP223 sensor modules present and attached

☐ All three 3.5 mm switch jacks present and undamaged

☐ NeoPixel LED present and not physically damaged

### E.2.2 Firmware and Startup Checks

☐ Device powers on — LED activates

☐ Serial Monitor at 115200 baud shows complete 8-line startup sequence

☐ ADVERTISING STARTED message confirmed

☐ Firmware version confirmed in Serial Monitor or source file

### E.2.3 Bluetooth Checks

☐ BT Switch Node (or custom name) visible in iPad Bluetooth scan

☐ Pairing completes without errors

☐ iPad shows Connected status

☐ Power-cycle reconnection test: power off device, power back on, iPad reconnects automatically within 10 seconds

### E.2.4 Input Verification — Touch Sensors

☐ Touch Sensor 1 activates — Serial Monitor shows TOUCH 0 -> SHIFT+TAB — LED turns Purple

☐ Touch Sensor 2 activates — Serial Monitor shows TOUCH 1 -> TAB — LED turns Red

☐ Touch Sensor 3 activates — Serial Monitor shows TOUCH 2 -> ENTER — LED turns Green

### E.2.5 Input Verification — Switch Jacks

☐ Switch Jack 1 activates with test switch — Serial Monitor shows SWITCH 0 -> SHIFT+TAB — LED turns Blue

☐ Switch Jack 2 activates — Serial Monitor shows SWITCH 1 -> TAB — LED turns Cyan

☐ Switch Jack 3 activates — Serial Monitor shows SWITCH 2 -> ENTER — LED turns Yellow

### E.2.6 Switch Control Integration Test

☐ Switch Control enabled on iPad

☐ All intended inputs assigned in Switch Control

☐ Switch Control scanning responds to touch inputs

☐ Switch Control scanning responds to adaptive switch inputs

☐ Selection action confirmed functional

### E.2.7 Final Result

Result | Technician Signature | Date
PASS / FAIL (circle one)

If FAIL: Document failure mode below and do not deploy unit until resolved.

Failure notes:

_____________________________________________________________________________

_____________________________________________________________________________

# SECTION F — ASSET MANAGEMENT

## F.1 Inventory Record Template

Maintain one row per physical device in the district inventory system. The master inventory may be kept in a spreadsheet, database, or district asset management platform.

Field | Description / Format
Asset Number | District-assigned unique identifier (e.g., AT-2024-001)
Bluetooth Name | Advertised BLE name programmed in firmware
Firmware Version | Version string from source file or Serial Monitor
Build Date | Date unit was assembled and flashed
Acceptance Test Date | Date of most recent acceptance test
Acceptance Test Result | PASS or FAIL
Current Building | Building name or code
Current Room | Room number
Assigned Staff | Teacher or AT specialist name
Assigned Student | Use student ID only — do not record student name in inventory
Last Inspection Date | Date of most recent monthly inspection
Next Inspection Due | Calculated 30 days from last inspection
Replacement Parts Date | Date of any hardware replacement (note what was replaced)
Decommission Date | Date unit was retired from service
Notes | Any relevant operational notes

## F.2 Device Checkout Form

Complete when any unit leaves the technology department or changes assignment.

DEVICE CHECKOUT FORM — BLE Adaptive Switch Node

Field | Entry
Asset Number
Bluetooth Name
Firmware Version
Checked Out To (Staff Name)
Building / Room
Student ID (if assigned)
Date Checked Out
Expected Return Date (if temporary)
Condition at Checkout (circle): | Good / Minor wear / Needs repair

Technology Staff Signature | Date

Receiving Staff Signature | Date

# SECTION G — TEACHER TRAINING HANDOUT

## G.1 Daily Startup Procedure

Complete the following every morning before student arrival:

1. | Power on the switch node using the USB-C cable or built-in battery switch.
2. | Wait 10 seconds for the device to initialize and begin advertising.
3. | On the student's iPad, open Settings → Bluetooth.
4. | Confirm BT Switch Node (or your unit's custom name) shows Connected.
5. | If not Connected, tap the device name to reconnect.
6. | Open Settings → Accessibility → Switch Control and confirm it is enabled.
7. | Test each switch the student uses with a brief activation — confirm the cursor moves.
8. | If Switch Control does not respond to a switch, see Section G.3 below.

## G.2 Daily Shutdown Procedure

63. Disconnect the switch node from the student's work area.
64. Visually inspect cables for any damage, kinking, or fraying.
65. Inspect switch jacks for secure seating — wiggle each adaptive switch cable gently.
66. Power off the device or leave connected to charge as per your building's protocol.
67. Store the device in its designated location — not in a drawer with sharp objects.

## G.3 Basic Troubleshooting (No Tech Required)

Switch stopped working mid-session:

Step 1: Check the Bluetooth status — Settings → Bluetooth → should show Connected.

Step 2: If Disconnected, tap the device name to reconnect.

Step 3: Check the physical cable between the adaptive switch and the device jack.

Step 4: Try a different switch jack on the device.

Step 5: If still not working, contact your AT specialist or technology staff.

Device disappeared from Bluetooth:

Step 1: Power off the switch node completely.

Step 2: Power it back on. Wait 15 seconds.

Step 3: On iPad, open Settings → Bluetooth — the device should reappear.

Step 4: Tap to reconnect.

Step 5: If it does not appear within 30 seconds, try forgetting the device and re-pairing.

## G.4 What to Report to Technology Staff

- Device will not power on after trying two different cables
- Bluetooth will not reconnect after repeated restarts
- One or more inputs never register in any test
- Physical damage to the enclosure, cables, or connectors
- NeoPixel LED is completely dark and does not illuminate on any input

# SECTION H — PARAEDUCATOR QUICK REFERENCE CARD

PRINT THIS PAGE AND KEEP IT WITH THE DEVICE.

Laminate for durability.

## Every Morning

☐ Power on the switch node

☐ iPad shows Connected next to the device name in Bluetooth settings

☐ Activate each switch once — the iPad cursor moves

## If a Switch Stops Working

Try This First | Then Try | Then Call
Check iPad Bluetooth — shows Connected? | Reboot device: power off, wait 10 sec, power on | AT specialist or technology staff
Wiggle the cable at the jack connector | Try a different jack on the device | Technology staff if hardware issue
Restart Switch Control: turn it OFF, wait 5 sec, turn ON | Forget and re-pair the device in Bluetooth settings | AT specialist if Switch Control issue

## If the Device Disappears from Bluetooth

68. Power off the switch node.
69. Wait 10 seconds.
70. Power it back on.
71. Open Settings → Bluetooth on the iPad.
72. The device name should reappear under Other Devices.
73. Tap to reconnect.

## LED Color Guide

LED Color | Which Input Was Activated
Purple | Touch Sensor 1
Red | Touch Sensor 2
Green | Touch Sensor 3
Blue | Switch Jack 1
Cyan | Switch Jack 2
Yellow | Switch Jack 3
Dark / Off | No input or no Bluetooth connection

## Who to Call

Situation | Contact
Bluetooth will not reconnect after restart | Technology Department
Switch not working — hardware suspected | Technology Department
Student's scanning pattern needs adjustment | AT Specialist
Switch Control actions need reconfiguring | AT Specialist or Teacher
Physical damage to device | Technology Department

# SECTION I — TECHNOLOGY DEPARTMENT MAINTENANCE PROCEDURES

## I.1 Monthly Maintenance Checklist

Complete for every active unit each calendar month. File completed checklists in the device folder.

Check Item | Pass | Fail — Notes
Confirm current firmware version matches district-approved version | ☐
Power on — complete startup sequence in Serial Monitor | ☐
Bluetooth advertisement visible from iPad scan | ☐
Pair or reconnect — iPad shows Connected | ☐
Touch Sensor 1 activates — correct Serial output and LED color | ☐
Touch Sensor 2 activates — correct Serial output and LED color | ☐
Touch Sensor 3 activates — correct Serial output and LED color | ☐
Switch Jack 1 activates — correct Serial output and LED color | ☐
Switch Jack 2 activates — correct Serial output and LED color | ☐
Switch Jack 3 activates — correct Serial output and LED color | ☐
Power-cycle reconnection test passes | ☐
Physical inspection — no damage | ☐

Technician Signature | Date

## I.2 Quarterly Maintenance

- Physical inspection of all units: enclosure integrity, connector condition, cable condition
- Full inventory audit: confirm physical count matches database records
- Confirm all units reflect the current district-approved firmware version
- Review any incident reports filed since the last quarterly review
- Update inventory records with current building/room/staff assignments

## I.3 Annual Maintenance

- Reflash all units with the then-current district-approved firmware
- Complete full acceptance test (Section E) on every unit after reflashing
- Update the change log (Section L) with annual firmware version
- Review and update all training materials if firmware behavior has changed
- Conduct full inventory audit and decommission any damaged or obsolete units

## I.4 Firmware Update Approval Form

Complete before deploying any new firmware version district-wide.

Field | Entry
New Firmware Version
Previous Firmware Version
Date of Change
Summary of Changes
Testing Completed By
Number of Units Tested
Pass Rate
Approved By (Technology Director)
Approved By (AT Coordinator)
Deployment Date

Technology Director Signature | Date

AT Coordinator Signature | Date

# SECTION J — AT SPECIALIST EVALUATION FORM

## J.1 Purpose

This form is completed by the Assistive Technology Specialist when evaluating a student's use of the BLE Adaptive Switch Node. It documents the student's current access method, performance metrics, and recommendations for the IEP team.

FERPA NOTICE: This form contains student-specific information. Store per district FERPA policies. Do not attach to or store with any device hardware.

## J.2 Student and Device Information

Field | Entry
Student ID (do not write name on device forms)
Evaluation Date
AT Specialist Name
IEP Meeting Date (if applicable)
Device Asset Number Used During Evaluation
Switch Configuration Evaluated

## J.3 Access Method Evaluation

### J.3.1 Current Access Method

☐ Capacitive Touch Sensors (TTP223)

☐ Adaptive Switches via 3.5 mm jack

☐ Combination of touch and adaptive switch

☐ Access method currently under evaluation — not yet determined

### J.3.2 Physical Positioning

Describe switch or sensor placement observed during evaluation:

_____________________________________________________________________________

_____________________________________________________________________________

### J.3.3 Accuracy

Metric | Observation
Correct activations per 10 attempts
Unintended activations per 10 attempts
Average time from intent to activation
Consistent activation force / contact? | Yes / No / Variable

### J.3.4 Fatigue

Metric | Observation
Duration of sustained use before fatigue signs
Observed fatigue indicators (describe)
Recommended maximum session length

### J.3.5 Student Response to LED Feedback

☐ Student notices and responds to LED color changes

☐ LED feedback does not appear to influence student behavior

☐ LED feedback is distracting — consider covering or disabling

## J.4 Recommendations

Switch configuration recommendation for IEP:

_____________________________________________________________________________

_____________________________________________________________________________

Positioning recommendation:

_____________________________________________________________________________

Training recommendation for staff:

_____________________________________________________________________________

Follow-up evaluation recommended: Yes / No If yes, within: ________ weeks

AT Specialist Signature | Date

# SECTION K — FERPA AND STUDENT PRIVACY GUIDANCE

## K.1 What FERPA Requires

The Family Educational Rights and Privacy Act (FERPA) prohibits the unauthorized disclosure of personally identifiable information from student education records. When deploying the BLE Adaptive Switch Node, technology staff and educators must follow the guidelines in this section.

## K.2 What Must NOT Be Stored on the Device

The ESP32-S3 Supermini has no non-volatile data storage accessible to the firmware beyond the program flash.

No student information of any kind is stored on or transmitted by the device firmware.

However, district staff must still comply with the following restrictions:

### K.2.1 Bluetooth Device Names Must Not Contain:

- Student full names or partial names
- Student ID numbers
- Any medical diagnosis or disability category
- Classroom identifiers that would allow identification of a specific student

COMPLIANT naming examples:

BT Switch Node B1-001

BT Switch Node Room 14A

Switch Node 07

NON-COMPLIANT naming examples:

BT Switch Node John Smith (contains student name)

Switch 042839 (contains student ID)

CP Switch Node Room 14 (contains disability category)

## K.3 Inventory Systems

- Inventory databases that link Asset Numbers to student identifiers must be stored in systems that comply with district FERPA data governance policies.
- Printed inventory sheets containing student ID assignments must be stored securely and not left in classrooms.
- Device labels must use asset numbers only, never student names.

## K.4 Evaluation Records

- AT specialist evaluation forms (Section J) contain student-identifiable information.
- These forms must be stored in the student's file per FERPA requirements.
- Do not photograph, scan, or transmit these forms through non-secure channels.
- Completed evaluation forms must not be left with the physical device or in unsecured classrooms.

## K.5 Questions

Contact your district FERPA compliance officer or special education director if you have questions about whether a specific practice complies with FERPA.

# SECTION L — MULTI-BUILDING DEPLOYMENT STANDARDS

## L.1 Device Naming Convention

When deploying multiple units across buildings, program a unique Bluetooth name into each unit's firmware before flashing. This prevents confusion when multiple devices are powered in the same space.

### L.1.1 Recommended Naming Format

Format: BT Switch Node [Building Code]-[Unit Number]

Examples:

BT Switch Node B1-001 (Building 1, Unit 001)

BT Switch Node B1-002 (Building 1, Unit 002)

BT Switch Node B2-001 (Building 2, Unit 001)

BT Switch Node ES-014 (Elementary School, Unit 014)

BT Switch Node MS-003 (Middle School, Unit 003)

### L.1.2 How to Change the Bluetooth Name

Before compiling firmware for a specific unit, locate this line in the .ino source file:

NimBLEDevice::init("BT Switch Node");

Change the name string to the unit's assigned name:

NimBLEDevice::init("BT Switch Node B1-001");

Compile and flash the firmware. Each unit will now advertise its unique name.

## L.2 Central Inventory Database

Maintain a single district-level inventory that tracks all units regardless of building. At minimum, include:

- Asset number
- Bluetooth name (must match what is programmed in firmware)
- Current building and room
- Current staff assignment
- Student ID assignment (secured per FERPA)
- Firmware version
- Last acceptance test date

## L.3 Cross-Building Transfer Procedure

When a unit moves from one building to another:

74. Update the inventory record with new building, room, and staff assignment.
75. Confirm the Bluetooth name is appropriate for the new location (rename in firmware if needed).
76. Complete a transfer inspection using the monthly checklist (Section I.1).
77. Notify the receiving building's AT specialist of the transfer.
78. Confirm the iPad in the new location can successfully pair or reconnect.

# SECTION M — CHANGE MANAGEMENT AND FIRMWARE VERSION CONTROL

## M.1 Firmware Version Log

Record every firmware version ever deployed district-wide. Never delete previous entries.

Version Number | Release Date | Approved By | Change Summary | Rollback Procedure
1.0.0 (initial) | | | Initial district deployment | N/A — first version

## M.2 Change Approval Process

79. Technology staff or AT coordinator identifies need for firmware change.
80. Proposed change is documented and tested on at least 2 units before broad deployment.
81. Technology Director and AT Coordinator review and sign the Firmware Update Approval Form (Section I.4).
82. Approved firmware is deployed to all units within the designated maintenance window.
83. All units are acceptance tested post-flash (abbreviated or full per supervisor direction).
84. Version log is updated.

## M.3 Rollback Procedure

If a new firmware version causes operational problems:

85. Locate the previous approved firmware source files in the district technology archive.
86. Flash all affected units with the previous version using the standard procedure (Section B).
87. Document the rollback in the firmware version log with date and reason.
88. Do not deploy the problem version to additional units until the issue is resolved.

ARCHIVE REQUIREMENT: All firmware source files for every version ever deployed must be retained

permanently. Store in district technology network storage, not only on individual computers.

Loss of a previous firmware version removes the ability to roll back.

# SECTION N — PRINTABLE APPENDICES

## Appendix A — Device Checkout Form

(See Section F.2 for the full form. Reproduce this page for daily use.)

Field | Entry
Asset Number
Bluetooth Name
Date Checked Out
Checked Out To
Building / Room
Student ID
Condition at Checkout | Good / Minor wear / Needs repair
Expected Return Date

Borrowing Staff Signature | Date

Technology Staff Signature | Date

## Appendix B — Classroom Daily Verification Form

Teacher or paraeducator completes daily. Keep with the device or in the classroom binder.

Date | Powered On | BT Connected | Switches Tested | Issue Noted | Initials
| ☐ | ☐ | ☐
| ☐ | ☐ | ☐
| ☐ | ☐ | ☐
| ☐ | ☐ | ☐
| ☐ | ☐ | ☐
| ☐ | ☐ | ☐
| ☐ | ☐ | ☐
| ☐ | ☐ | ☐
| ☐ | ☐ | ☐
| ☐ | ☐ | ☐

## Appendix C — Incident Report Form

Field | Entry
Asset Number
Date of Incident
Reported By (name and role)
Building / Room
Student ID (if involved)
Description of Incident
Immediate Action Taken
Follow-up Required? | Yes / No
Assigned To (for follow-up)
Resolution Date
Resolution Summary

Reporting Staff Signature | Date

Technology Staff Signature | Date

## Appendix D — Annual Inspection Form

Inspection Item | Pass | Fail — Notes
Enclosure — no cracks, loose parts, or sharp edges | ☐
USB-C connector functional for charging and data | ☐
All three TTP223 sensors present and responsive | ☐
All three 3.5 mm switch jacks present and functional | ☐
NeoPixel LED illuminates all colors correctly | ☐
Full startup sequence confirmed in Serial Monitor | ☐
Bluetooth advertising and pairing functional | ☐
All inputs verified with acceptance test (Section E) | ☐
Firmware version matches current approved version | ☐
Inventory record updated | ☐

Annual Inspection Technician | Date

Technology Director Approval | Date

## Appendix E — Firmware Update Approval Form

(See Section I.4 for the full form. Reproduce this page as needed.)

Field | Entry
New Firmware Version
Previous Firmware Version
Summary of Changes
Test Units Count
Test Pass Rate
Approved By — Technology Director
Approved By — AT Coordinator
Deployment Date
Rollback Instructions (attach or reference)

Technology Director Signature | Date

AT Coordinator Signature | Date

## Appendix F — AT Evaluation Worksheet (Abbreviated Field Copy)

(Full form in Section J. This is a condensed field copy for use during evaluation sessions.)

Field | Entry
Student ID
Evaluation Date
AT Specialist
Device Asset Number
Access Method Evaluated
Correct activations / 10 trials
Unintended activations / 10 trials
Fatigue threshold observed
Recommended switch configuration
Follow-up needed? | Yes / No Within: ___ weeks

AT Specialist Signature | Date

BLE Adaptive Switch Node — District Deployment Manual
